kaymantex68/nagrevatel_kamushin/фотографии в сборе/2.jpg

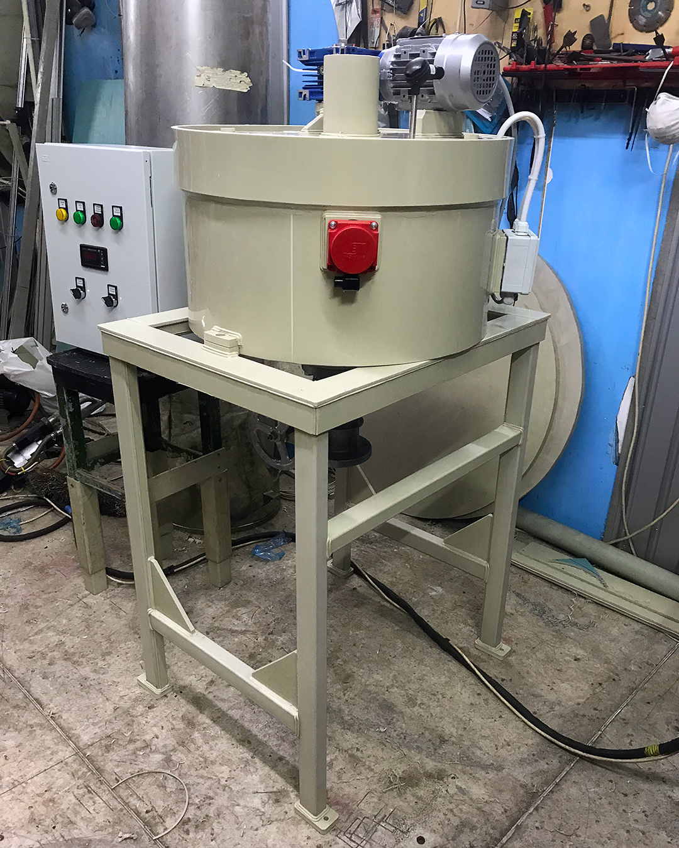
фотографии в сборе/2.jpg
