kaymantex68/nagrevatel_kamushin/фотографии в сборе/1.jpg

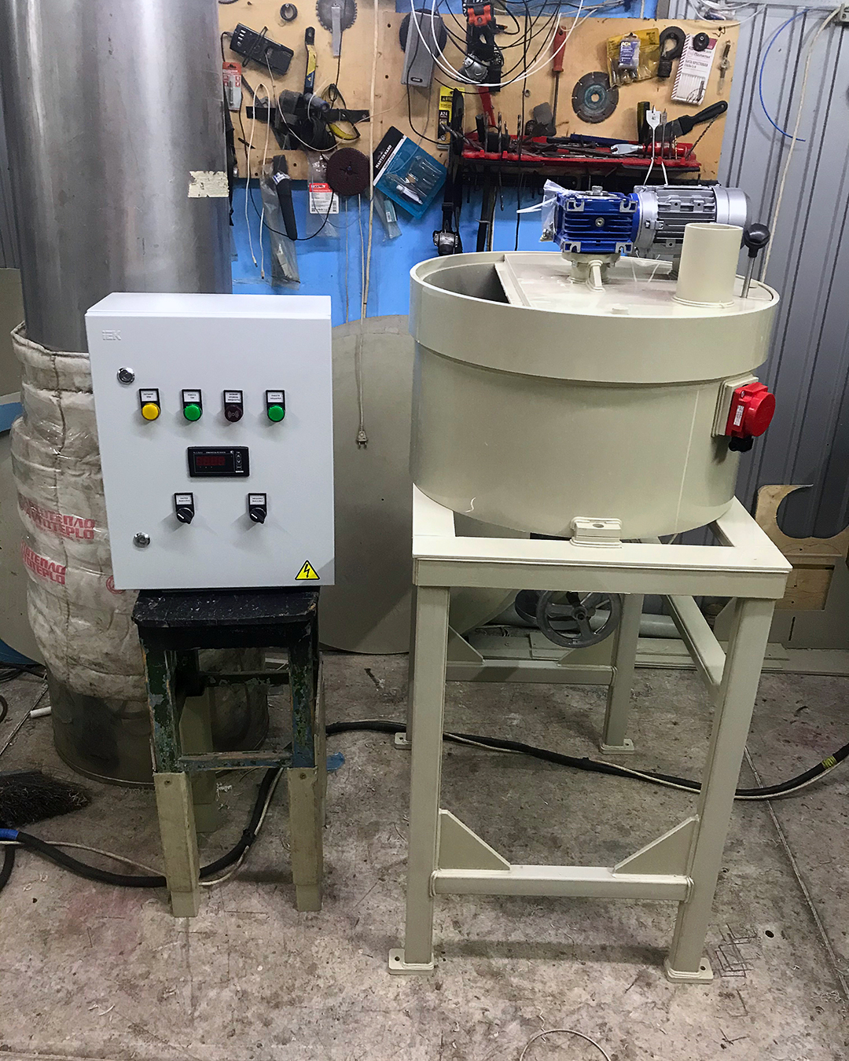
фотографии в сборе/1.jpg
