kaymantex68/nagrevatel_kamushin/Паспорт/1 титульный лист.pdf

АСУ нагревом ректора
промывки с мешалкой

ТЕХНОПЛАСТ ЭКО

Уварово 2021
