kaymantex68/nagrevatel_kamushin/Паспорт/2 содержание.pdf

Монтажная схема _______________________________________________________________ 3

Схема расключения _____________________________________________________________ 4

Монтаж и пусконаладочные работа _______________________________________________ 5

Схема копановки _______________________________________________________________ 6

содержание

2
