kaymantex68/nagrevatel_kamushin/Счет на оплату покупателю.xls

 |  |  |  |  | www.kaymantex.ru
ОТДЕЛЕНИЕ N8594 СБЕРБАНКА РОССИИ Г. ТАМБОВ |  |  |  |  |  | БИК |  |  | 046850649
 |  |  |  |  |  | Сч. № |  |  | 30101810800000000649
Банк получателя
ИНН |  | 683001236234 |  | КПП |  | Сч. № |  |  | 40802810861000006216
Индивидуальный предприниматель Хмыров Андрей Сергеевич
Получатель
Счет на оплату № 1 от 18 мая 2021 г.
Поставщик: |  |  | Индивидуальный предприниматель Хмыров Андрей Сергеевич, ИНН 683001236234, 392019, Тамбовская обл., г. Тамбов, ул. Агапкина/Ореховая, дом № 8/13, кв.50
Покупатель: |  |  | ИП Корнев Алексей Иванович, ИНН 683002654273, 393460, Тамбовская обл., г.Уварово, ул. Первомайская, д. 43
№ | Товары (работы, услуги) |  |  |  |  |  | Кол-во | Ед. |  | Цена |  | Сумма
1 | Выполнение электромонтажных работ (Договор б/н от 17.05.21) |  |  |  |  |  | 1 |  |  | 40000.00 |  | 40000.00
 |  |  |  |  |  |  |  |  |  |  | Итого: | 40000.00
 |  |  |  |  |  |  |  |  |  |  | Без налога (НДС) |  | -
 |  |  |  |  |  |  |  |  |  |  | Всего к оплате: | 40000.00
Всего наименований 1, на сумму 40 000,00 руб.
Сорок тысяч рублей 00 копеек
Предприниматель |  |  |  |  |  | Хмыров А. С.
