kaymantex68/nagrevatel_kamushin/Счет_117231_20_5_2021.xls

Внимание ! Оплата данного счета означает согласие с условиями поставки товара. Возврат товара после его отгрузки не допускается. Счет действителен в течение 3 банковских дней. Товар отпускается по факту прихода денег на р/с Поставщика, самовывозом, при н
ПОСТАВЩИК: ООО "АВС-электро"
394018, Воронежская обл, г. Воронеж, ул. Куцыгина, дом 17
Телефоны: (473) 246-00-00
РЕКВИЗИТЫ ПОСТАВЩИКА: ИНН 3664042290 КПП 366401001, р/с 40702810100250004707 Филиал "Центральный" Банка ВТБ (ПАО) в г. Москва, БИК 044525411, корр.сч. 30101810145250000411
Образец заполнения в платежном поручении поля "Назначение платежа" :
Оплата за товар по счету № 117231 от 20 Мая 2021 г., в т.ч. НДС 20% - 1'560.57 руб.
!!! При оплате нескольких счетов одним платежным поручением в графе "Назначение платежа" необходимо перечислять номера всех счетов, по которым производится оплата через запятую.
!!! При оплате счета другой организацией в платежном поручении ОБЯЗАТЕЛЬНО указывается за кого (наименование и ИНН организации) производится оплата.
Если оплата производится по договору, то в платежном поручении в поле "Назначение платежа" необходимо указать:
Оплата за товар по Договору № от (D), в т.ч. НДС 1'560.57 руб.
Счет N 117231 От 20 Мая 2021 г.
ПЛАТЕЛЬЩИК: ИП Хмыров Андрей Сергеевич, ИНН 683001236234 392000, Тамбовская обл, Тамбов г, Агапкина ул, дом 8/13, кв. 50, телефоны: +79204897437
№ | Код товара | Товар | Код каталога | Кол-во | Ед. | Цена | Сумма
1 | 1045672 | Выключатель автоматический 3-пол. 32А С 6kA OptiDin BM63 КЭАЗ |  | 1 | шт | 617 | 617
2 | 1045572 | Выключатель автоматический 1-пол. 6А С 6kA OptiDin BM63 КЭАЗ |  | 1 | шт | 195 | 195
3 | 1045609 | Выключатель автоматический 1-пол. 20А С 6kA OptiDin BM63 КЭАЗ |  | 1 | шт | 180 | 180
4 | 423466 | Контактор ПМЛ-2100-25А-380AC-УХЛ4-Б-КЭАЗ | ПМЛ-2100-25А-380AC | 1 | шт. | 842 | 842
5 | 423441 | Контактор ПМЛ-1160М-10А-220AC-УХЛ4-Б-КЭАЗ | ПМЛ-1160М-10А-220AC | 1 | шт. | 524 | 524
6 | 320500 | Автомат пуска двигателя АПД-32 2,5-4А EKF PROxima | apd2-2.5-4.0 | 1 | шт. | 1609.99 | 1609.99
7 | 52106 | Корпус металлический ЩМП-2-0 У2 IP54 (500х400х220) ИЭК | YKM40-02-54 | 1 | шт. | 4864.83 | 4864.83
8 | 720861 | Клемма пружинная ST 6 мм2 серая Phoenix Contact | 3031487 | 1 | шт | 80.35 | 80.35
9 | 662571 | Клемма пружинная ST 4 мм2 синяя BU Phoenix Contact | 3031377 | 1 | шт | 51.34 | 51.34
10 | 568901 | Клемма пружинная ST 4 мм2 серая Phoenix Contact | 3031364 | 1 | шт | 43.52 | 43.52
11 | 435253 | Клемма пружинная ST 4 мм2 ж/з PE Phoenix Contact | 3031380 | 1 | шт | 130.57 | 130.57
12 | 459699 | Держатель маркировки DM 18x25 ИЭК | DM18X25 | 6 | шт | 20.9 | 125.4
13 | 1118536 | Маркировка для провода, гибкая, для трубочек. 4х12мм. Белая | NUTFL12 | 50 | шт | 1.99 | 99.5
 |  |  |  |  | Итого: |  | 9363.50 руб.
 |  |  |  |  | В том числе
 |  |  |  |  | НДС: |  | 1560.57 руб.
Всего наименований 13, на сумму 9'363.50 руб.
Сумма: Девять тысяч триста шестьдесят три рубля 50 копеек
 | Составил ____________________ /Милованова Надежда Петровна/
 | Руководитель ___________________/Шишкина Наталья Ивановна/ |  |  | Бухгалтер ____________________
Примечание: При поставке кабельно-проводниковой продукции, изготавливаемой под заказ, допускается отклонение в количестве в пределах +/-5%. Окончательный счет, с учетом отклонений по количеству, выставляется по факту поставки.
Счет составлен в филиале: г.Тамбов, ул.Чичерина, д.54а, телефоны филиала: +7 (4752) 75-61-62 доб. 3215
