kaymantex68/nagrevatel_kamushin/(list of files, cad)

Other CAD files:
Монтажная схема.dxf
Монтажная схема.dwg
