kaymantex68/nagrevatel_kamushin/Монтажная схема.pdf

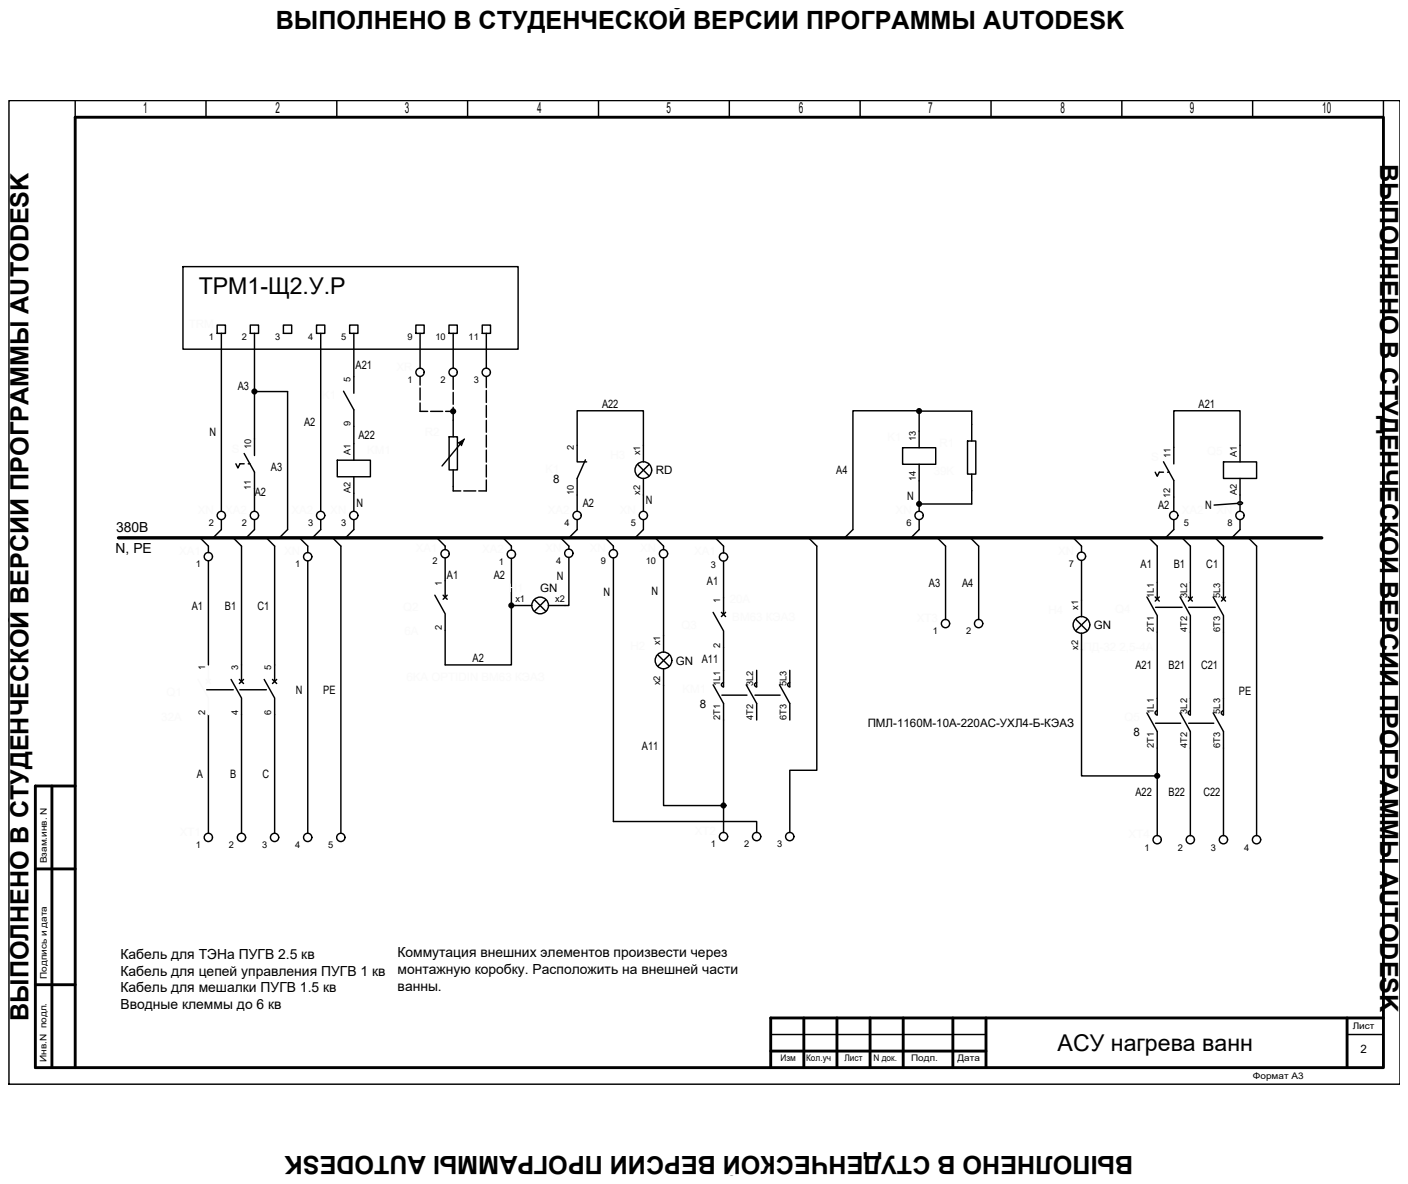
[picture p3: page 1]

ВЫПОЛНЕНО В СТУДЕНЧЕСКОЙ ВЕРСИИ ПРОГРАММЫ AUTODESK

Инв.N подл. Подпись и дата Взам.инв. N Формат А3 Изм Кол.уч Лист N док. Подп. Дата Лист АСУ нагрева ванн 2 ТРМ1-
