kaymantex68/nagrevatel_kamushin/Схема компановки.pdf

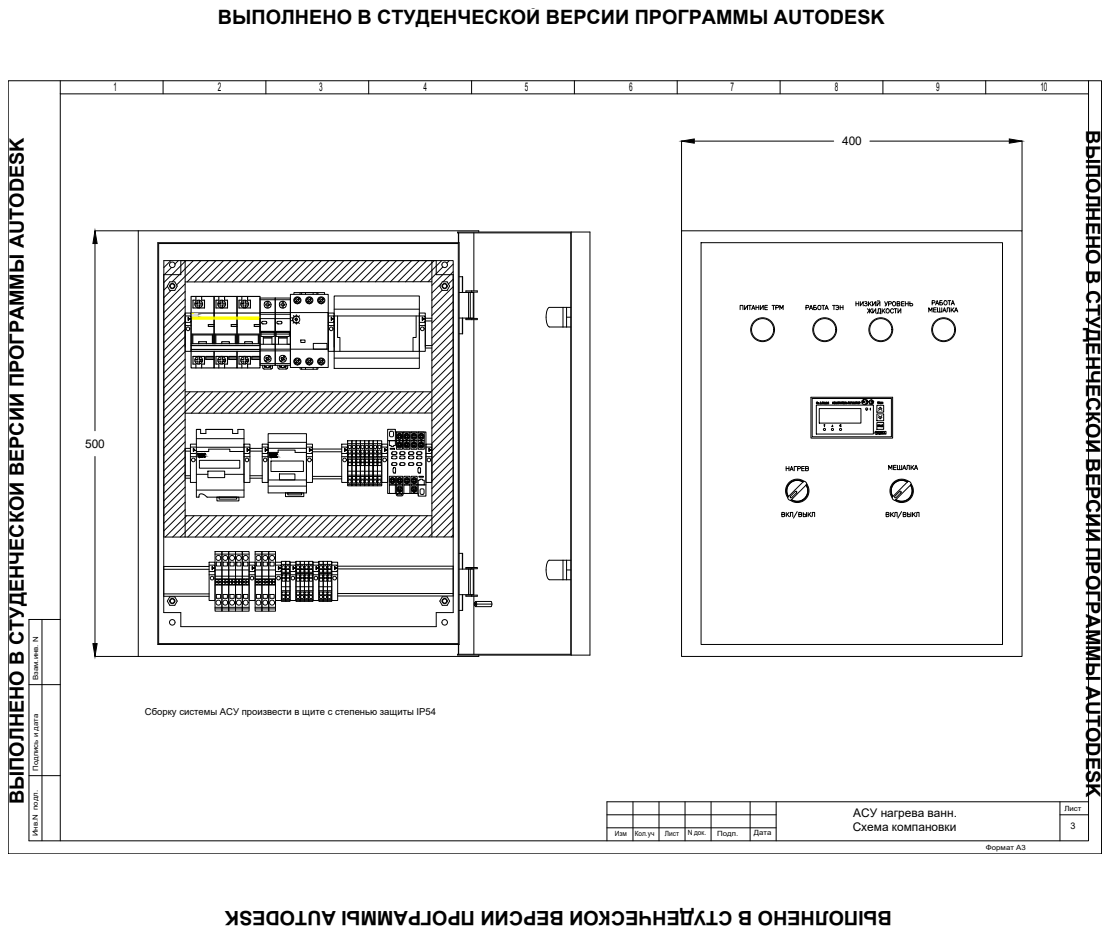
[picture p4: page 1]

ВЫПОЛНЕНО В СТУДЕНЧЕСКОЙ ВЕРСИИ ПРОГРАММЫ AUTODESK

Инв.N подл. Подпись и дата Взам.инв. N Формат А3 Изм Кол.уч Лист N док. Подп. Дата Лист АСУ нагрева ванн. Схема компановки 3 Сборку системы АСУ произвести в щите с степенью защиты IP54 400 500
