kaymantex68/nagrevatel_kamushin/Паспорт/4 схема расключения.pdf

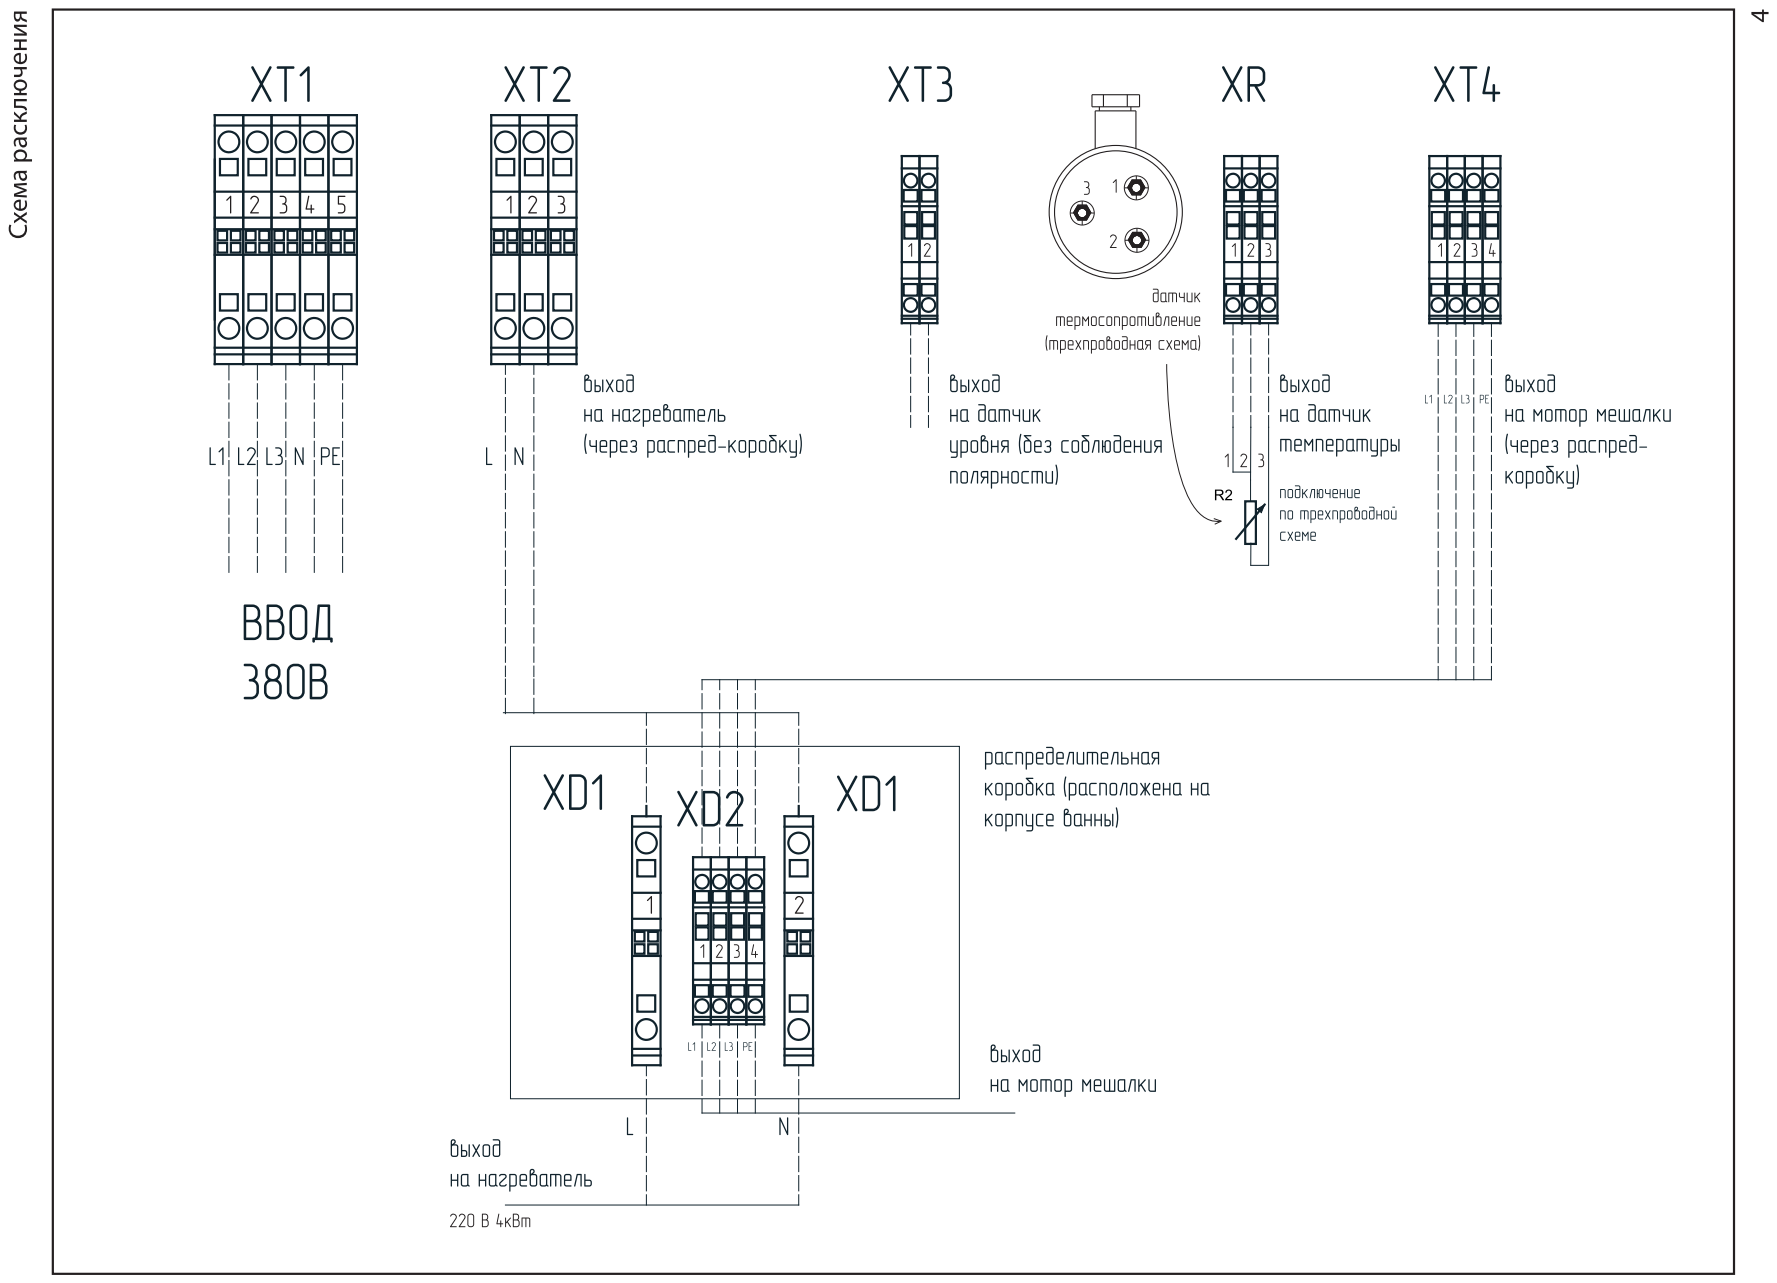
[picture p5: page 1]
