kaymantex68/nagrevatel_kamushin/Паспорт/3 монтажная схема.pdf

Т

Р

Исполнительная схема
